gokulhari012/time-teller-clock/Dev Tools/temp files/temp.py

schedule =[
  {
    "time": "06:05",
    "days": ["Monday", "Tuesday"],
    "months": ["June", "July"],
    "custom_song": "gokul.mp3"
  },
  {
    "time": "15:30",
    "days": ["Sunday"],
    "months": ["All"]
  }
] 


for entry in schedule:
    print("custom_song" in entry)
if None:
    print("None")
if True:
    print("True")
if False:
    print("False")
if "gokul"==True:
    print("gokul")
